GG23800/PT1000_sensor/image/project2.jpg

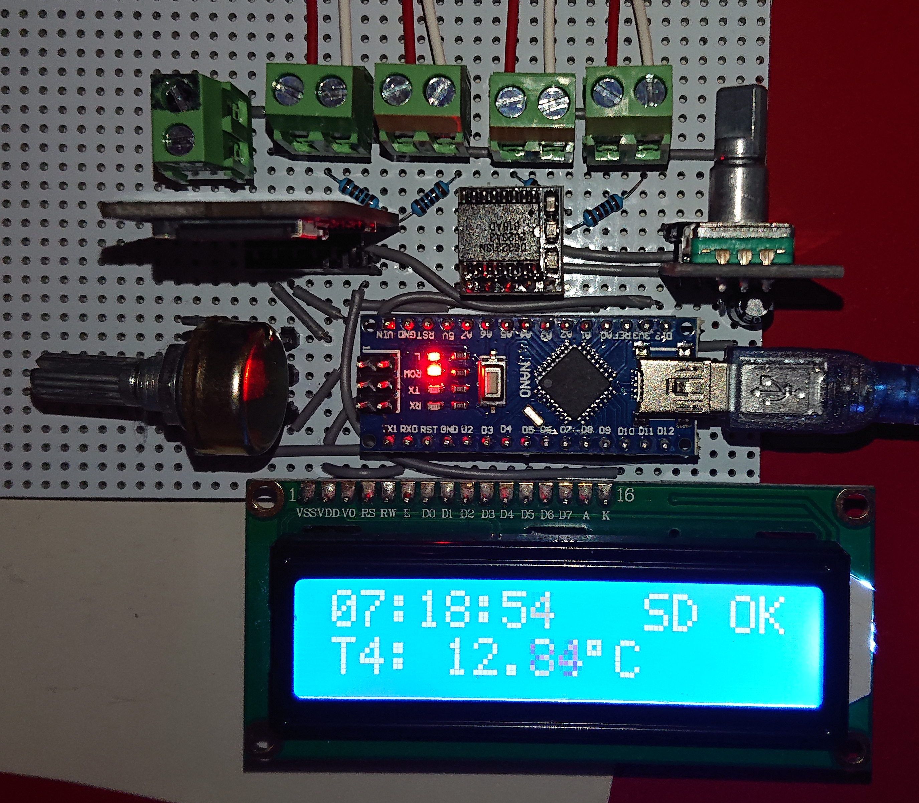
image/project2.jpg
