GG23800/PT1000_sensor/image/project1.jpg

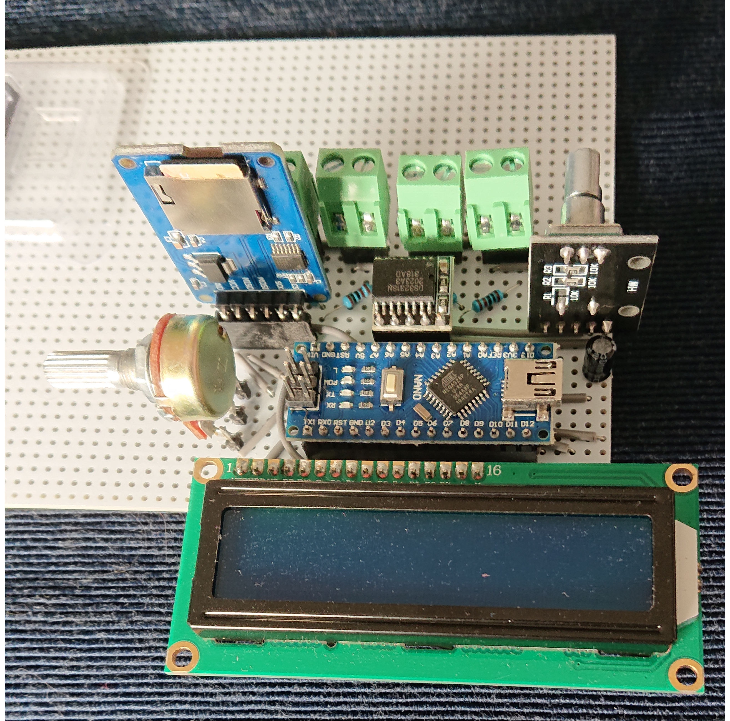
image/project1.jpg
