GG23800/PT1000_sensor/readme.md

## Informations

In this repository, we present a prototype of heating regulation using an arduino and PT1000 sensors. One can find full [english documentation](latex/en/readme_en.pdf) and [french documentation](latex/fr/readme_fr.pdf).

## Repo architecture

doc contain datasheet pdf file (for arduino, pump and RTC).

electronic file contain kicad source file with the project schematic.

image file contain image for documentation files.

latex contain the source file for the pdf readme files.

simuation contain octave source to simulate PT1000 behavior.

soft_arduino contain the firmware of the project.
