GG23800/PT1000_sensor/simulation/resistor_variation.pdf

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

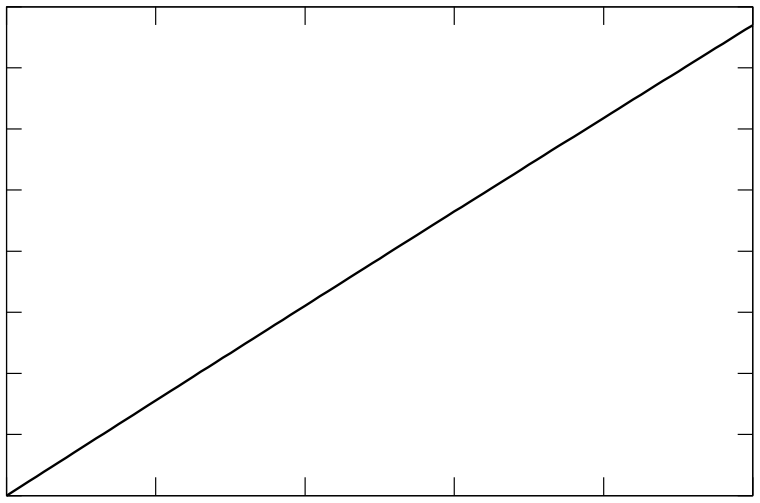
[picture p5: figure]
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
