GG23800/PT1000_sensor/image/full_schematic.png

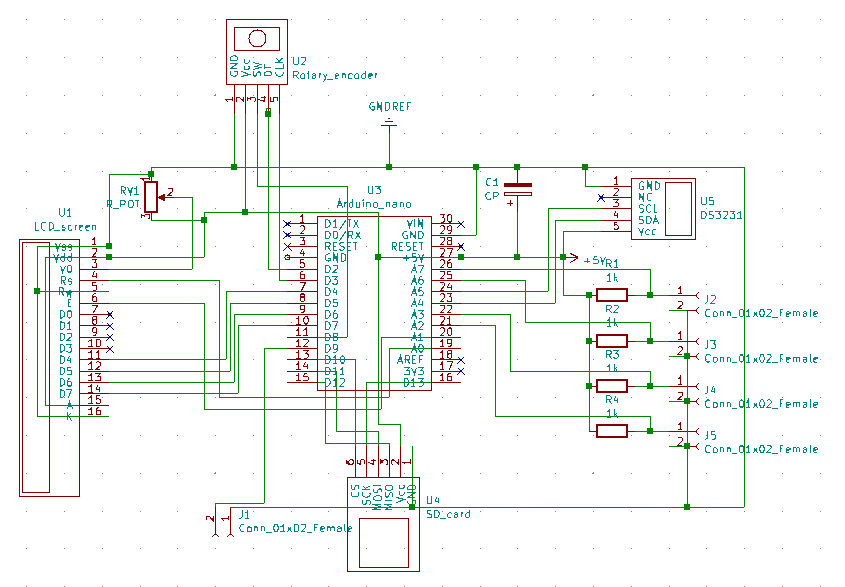
image/full_schematic.png
