GG23800/PT1000_sensor/image/LCD_schematic.png

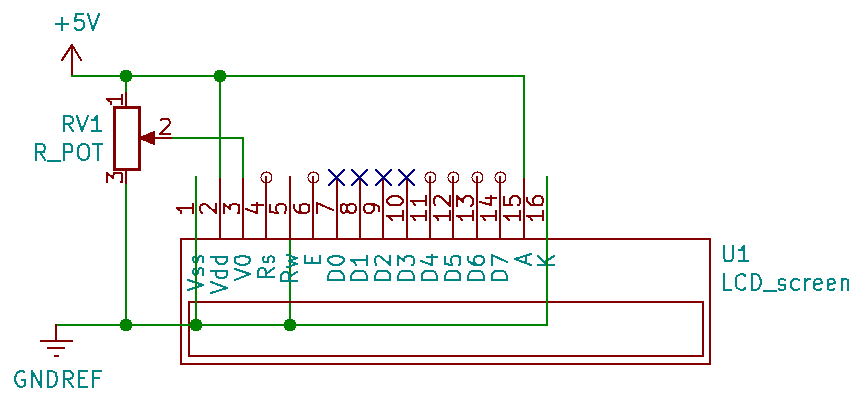
image/LCD_schematic.png
