GG23800/PT1000_sensor/image/PT1000_schematic.png

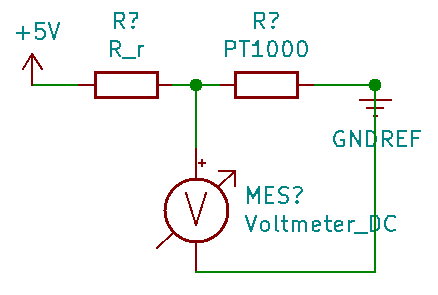
image/PT1000_schematic.png
