GG23800/PT1000_sensor/image/Rotary_Encoder_schematic.png

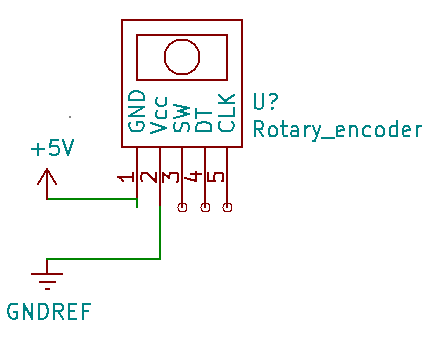
image/Rotary_Encoder_schematic.png
