GG23800/PT1000_sensor/image/RTC_schematic.png

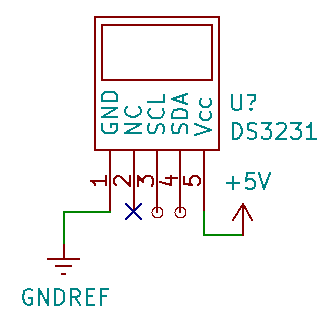
image/RTC_schematic.png
