GG23800/PT1000_sensor/image/SD_schematic.png

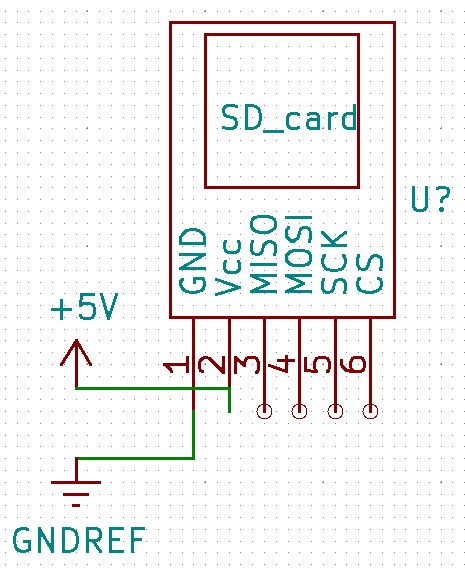
image/SD_schematic.png
