GG23800/PT1000_sensor/image/upm3_curve.png

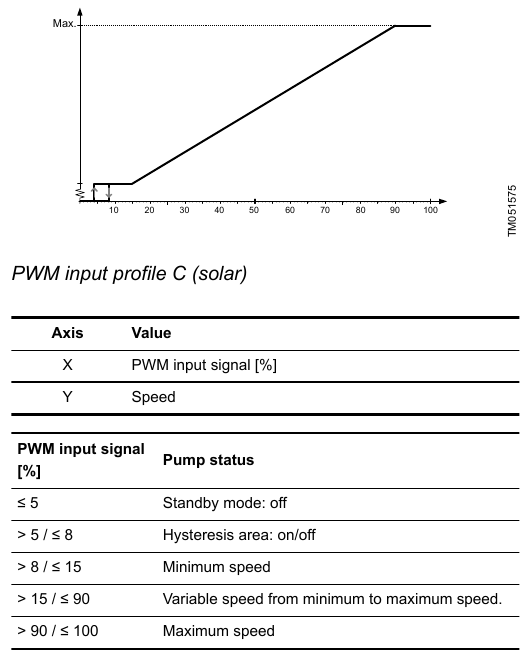
image/upm3_curve.png
