GG23800/PT1000_sensor/simulation/arduino_mesure.png

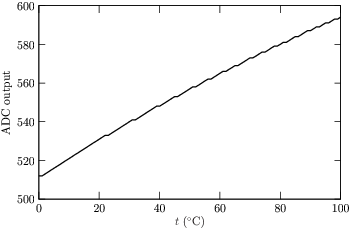
simulation/arduino_mesure.png
