GG23800/PT1000_sensor/simulation/linear_error.png

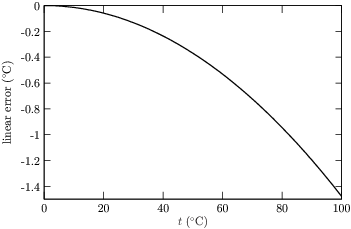
simulation/linear_error.png
