GG23800/PT1000_sensor/simulation/maximum_relative_voltage_variation.png

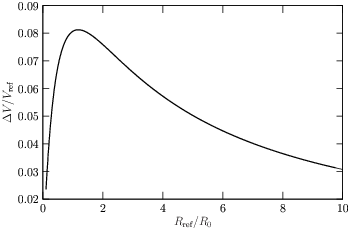
simulation/maximum_relative_voltage_variation.png
