GG23800/PT1000_sensor/simulation/resistor_variation.png

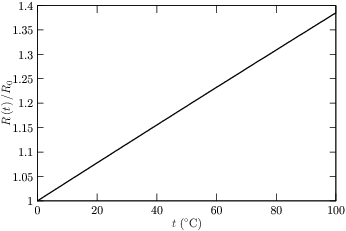
simulation/resistor_variation.png
